MaibornWolff/smart-devices-calling-card/docs/cards.jpg

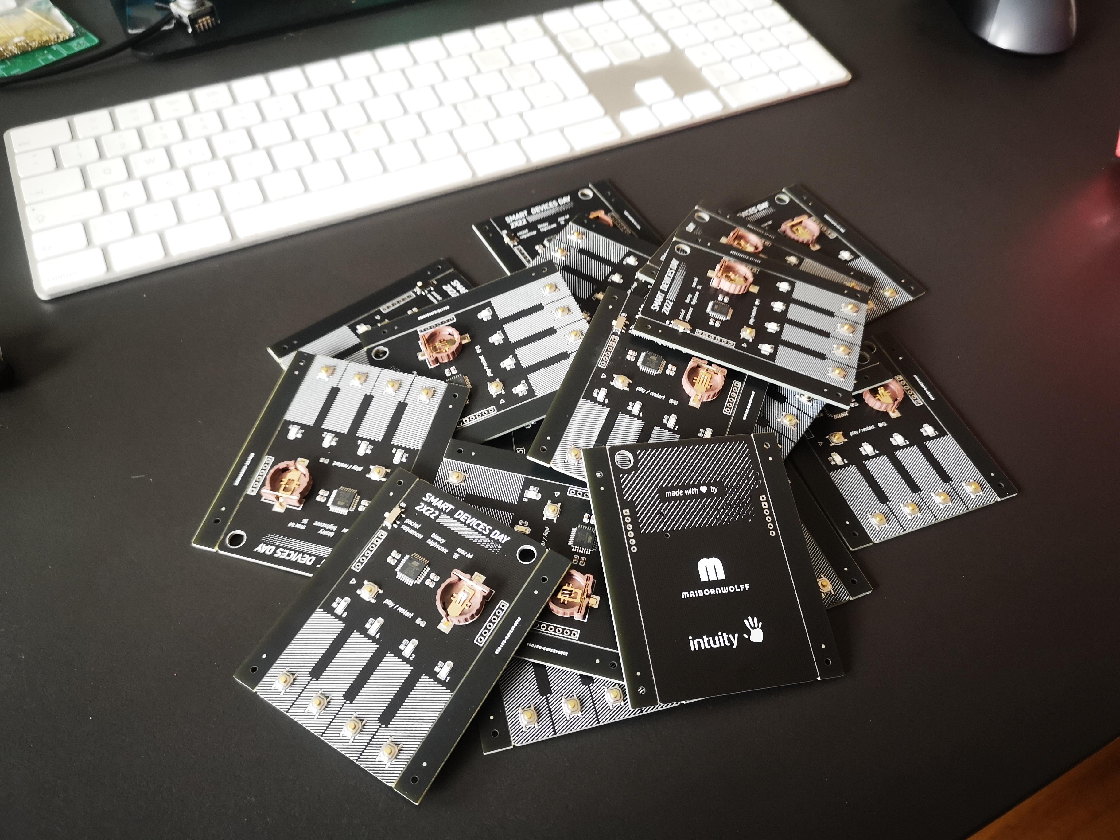
docs/cards.jpg
